Storm13Cloud/NanoFreak/NanoFreak.kicad_pcb

## KiCad design NanoFreak.kicad_pcb (2026-01-06)

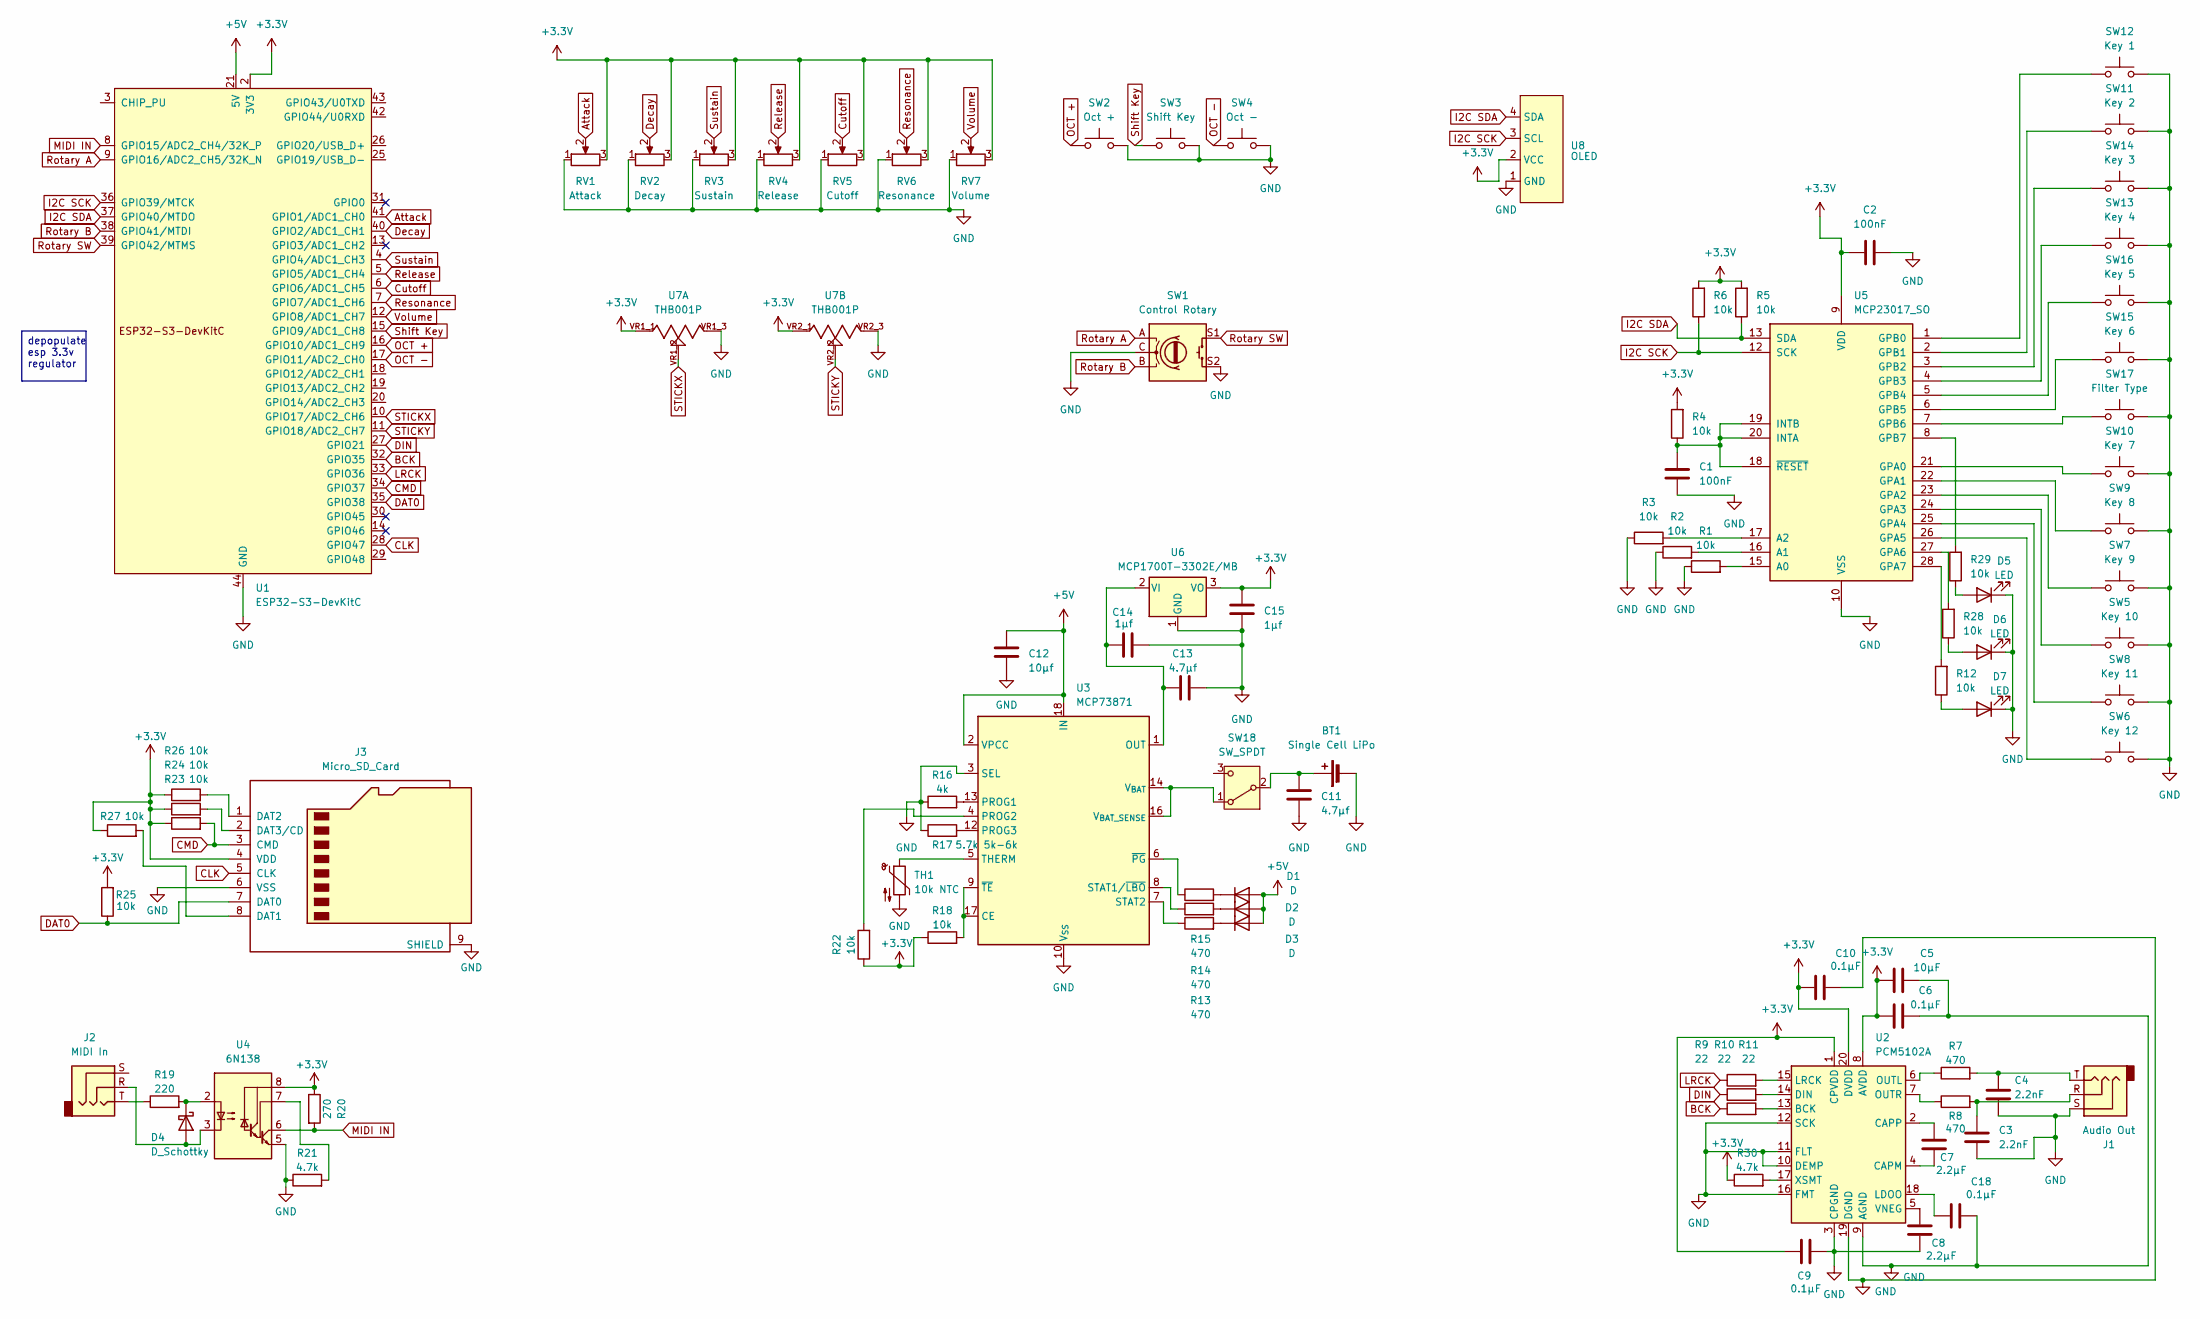
[picture p1: schematic NanoFreak.kicad_sch]

Parts:
BT1: Single Cell LiPo; BatteryHolder_Keystone_1042_1x18650
C1, C2: 100nF; C_0603_1608Metric_Pad1.08x0.95mm_HandSolder
C3, C4: 2.2nF; C_0603_1608Metric_Pad1.08x0.95mm_HandSolder
C5: 10µF; C_0603_1608Metric_Pad1.08x0.95mm_HandSolder
C6, C9, C10, C18: 0.1µF; C_0603_1608Metric_Pad1.08x0.95mm_HandSolder
C7, C8: 2.2µF; C_0603_1608Metric_Pad1.08x0.95mm_HandSolder
C11, C13: 4.7µf; C_0603_1608Metric_Pad1.08x0.95mm_HandSolder
C12: 10µf; C_0603_1608Metric_Pad1.08x0.95mm_HandSolder
C14, C15: 1µf; C_0603_1608Metric_Pad1.08x0.95mm_HandSolder
D1, D2, D3: D; D_0603_1608Metric_Pad1.05x0.95mm_HandSolder
D4: D_Schottky; D_0603_1608Metric_Pad1.05x0.95mm_HandSolder
D5, D6, D7: LED; LED_D3.0mm
J1: Audio Out; Jack_3.5mm_CUI_SJ1-3523N_Horizontal
J2: MIDI In; Jack_3.5mm_CUI_SJ1-3523N_Horizontal
J3: Micro_SD_Card; microSD_HC_Hirose_DM3AT-SF-PEJM5
R1, R2, R3, R4, R5, R6, R12, R18, R22, R23, R24, R25, R26, R27, R28, R29: 10k; R_0603_1608Metric
R7, R8, R13, R14, R15: 470; R_0603_1608Metric
R9, R10, R11: 22; R_0603_1608Metric
R16: 4k; R_0603_1608Metric
R17: 5.7k 5k-6k; R_0603_1608Metric
R19: 220; R_0603_1608Metric
R20: 270; R_0603_1608Metric
R21, R30: 4.7k; R_0603_1608Metric
RV1: Attack; Potentiometer
RV2: Decay; Potentiometer
RV3: Sustain; Potentiometer
RV4: Release; Potentiometer
RV5: Cutoff; Potentiometer
RV6: Resonance; Potentiometer
RV7: Volume; Potentiometer
SW1: Control Rotary; RotaryEncoder_Alps_EC11E-Switch_Vertical_H20mm
SW2: Oct +; SW_Push_1P1T_NO_CK_KMR2
SW3: Shift Key; SW_Push_1P1T_NO_CK_KMR2
SW4: Oct -; SW_Push_1P1T_NO_CK_KMR2
SW5: Key 10; SW_Cherry_MX_1.00u_PCB
SW6: Key 12; SW_Cherry_MX_1.00u_PCB
SW7: Key 9; SW_Cherry_MX_1.00u_PCB
SW8: Key 11; SW_Cherry_MX_1.00u_PCB
SW9: Key 8; SW_Cherry_MX_1.00u_PCB
SW10: Key 7; SW_Cherry_MX_1.00u_PCB
SW11: Key 2; SW_Cherry_MX_1.00u_PCB
SW12: Key 1; SW_Cherry_MX_1.00u_PCB
SW13: Key 4; SW_Cherry_MX_1.00u_PCB
SW14: Key 3; SW_Cherry_MX_1.00u_PCB
SW15: Key 6; SW_Cherry_MX_1.00u_PCB
SW16: Key 5; SW_Cherry_MX_1.00u_PCB
SW17: Filter Type; SW_Push_1P1T_NO_CK_KMR2
SW18: SW_SPDT; SW_SPDT_PCM12
TH1: 10k NTC; R_0603_1608Metric_Pad0.98x0.95mm_HandSolder
U1: ESP32-S3-DevKitC
U2: PCM5102A; TSSOP-20_4.4x6.5mm_P0.65mm
U3: MCP73871; QFN-20-1EP_4x4mm_P0.5mm_EP2.5x2.5mm
U4: 6N138; DIP-8_W7.62mm
U5: MCP23017_SO; SOIC-28W_7.5x17.9mm_P1.27mm
U6: MCP1700T-3302E/MB; SOT-89-3
U7: THB001P; CNK_THB001P; PARTREV 27 Jan 22
U8: OLED; OLED 128x64

Connections:
+3.3V: C2.1, C5.1, C6.1, C9.2, C10.1, C15.1, J3.4 (VDD), R4.2, R5.2, R6.2, R18.1, R20.1, R22.1, R23.1, R24.1, R25.2, R26.1, R27.1, R30.1, RV1.3, RV2.3, RV3.3, RV4.3, RV5.3, RV6.3, RV7.3, U1.1 (3V3), U1.2 (3V3), U2.1 (CPVDD), U2.8 (AVDD), U2.20 (DVDD), U4.8 (VCC), U5.9 (VDD), U6.3 (VO), U7.VR1_1, U7.VR2_1, U8.2 (VCC)
+5V: C12.1, D1.2 (A), D2.2 (A), D3.2 (A), U1.21 (5V), U3.2 (VPCC), U3.18 (IN), U3.19 (IN)
Attack: RV1.2, U1.41 (GPIO1/ADC1_CH0)
BCK: R11.1, U1.32 (GPIO35)
CLK: J3.5 (CLK), U1.28 (GPIO47)
CMD: J3.3 (CMD), R23.2, U1.34 (GPIO37)
Cutoff: RV5.2, U1.6 (GPIO6/ADC1_CH5)
DAT0: J3.7 (DAT0), R25.1, U1.35 (GPIO38)
DIN: R10.1, U1.27 (GPIO21)
Decay: RV2.2, U1.40 (GPIO2/ADC1_CH1)
GND: BT1.2 (-), C1.2, C2.2, C3.2, C4.2, C5.2, C6.2, C8.2, C9.1, C10.2, C11.2, C12.2, C13.2, C14.2, C15.2, C18.2, D5.1 (K), D6.1 (K), D7.1 (K), J1.S, J3.6 (VSS), J3.9 (SHIELD), R1.1, R2.1, R3.1, R16.1, R17.1, R21.1, RV1.1, RV2.1, RV3.1, RV4.1, RV5.1, RV6.1, RV7.1, SW1.C, SW1.S2, SW2.2, SW3.2, SW4.2, SW5.2, SW6.2, SW7.2, SW8.2, SW9.2, SW10.2, SW11.2, SW12.2, SW13.2, SW14.2, SW15.2, SW16.2, SW17.2, TH1.2, U1.22 (GND), U1.23 (GND), U1.24 (GND), U1.44 (GND), U2.3 (CPGND), U2.9 (AGND), U2.10 (DEMP), U2.11 (FLT), U2.12 (SCK), U2.16 (FMT), U2.19 (DGND), U3.3 (SEL), U3.10 (V_{SS}), U3.11 (V_{SS}), U3.21 (V_{SS}), U4.5 (GND), U5.10 (VSS), U6.1 (GND), U7.VR1_3, U7.VR2_3, U8.1 (GND)
I2C SCK: R6.1, U1.36 (GPIO39/MTCK), U5.12 (SCK), U8.3 (SCL)
I2C SDA: R5.1, U1.37 (GPIO40/MTDO), U5.13 (SDA), U8.4 (SDA)
LRCK: R9.1, U1.33 (GPIO36)
MIDI IN: R20.2, U1.8 (GPIO15/ADC2_CH4/32K_P), U4.6 (VO2)
unnamed: BT1.1 (+), C11.1, SW18.2 (B)
unnamed: C3.1, J1.R, R8.2
unnamed: C4.1, J1.T, R7.2
unnamed: D1.1 (K), R15.2
unnamed: D2.1 (K), R14.2
unnamed: D3.1 (K), R13.2
unnamed: D4.2 (A), J2.R, U4.3 (C2)
unnamed: D4.1 (K), R19.2, U4.2 (C1)
unnamed: D5.2 (A), R29.1
unnamed: D6.2 (A), R28.1
unnamed: D7.2 (A), R12.1
unnamed: J2.T, R19.1
unnamed: J3.8 (DAT1), R27.2
unnamed: J3.1 (DAT2), R26.2
unnamed: J3.2 (DAT3/CD), R24.2
unnamed: SW18.1 (A), U3.14 (V_{BAT}), U3.15 (V_{BAT}), U3.16 (V_{BAT_SENSE})
unnamed: R11.2, U2.13 (BCK)
unnamed: C7.2, U2.4 (CAPM)
unnamed: C7.1, U2.2 (CAPP)
unnamed: R10.2, U2.14 (DIN)
unnamed: C18.1, U2.18 (LDOO)
unnamed: R9.2, U2.15 (LRCK)
unnamed: R7.1, U2.6 (OUTL)
unnamed: R8.1, U2.7 (OUTR)
unnamed: C8.1, U2.5 (VNEG)
unnamed: R30.2, U2.17 (XSMT)
unnamed: R18.2, U3.9 (~TE), U3.17 (CE)
unnamed: R16.2, U3.13 (PROG1)
unnamed: R22.2, U3.4 (PROG2)
unnamed: R17.2, U3.12 (PROG3)
unnamed: R14.1, U3.8 (STAT1/~LBO)
unnamed: R13.1, U3.7 (STAT2)
unnamed: TH1.1, U3.5 (THERM)
unnamed: R15.1, U3.6 (~PG)
unnamed: R21.2, U4.7 (VO1)
unnamed: R1.2, U5.15 (A0)
unnamed: R2.2, U5.16 (A1)
unnamed: R3.2, U5.17 (A2)
unnamed: SW10.1, U5.21 (GPA0)
unnamed: SW9.1, U5.22 (GPA1)
unnamed: SW7.1, U5.23 (GPA2)
unnamed: SW5.1, U5.24 (GPA3)
unnamed: SW8.1, U5.25 (GPA4)
unnamed: SW6.1, U5.26 (GPA5)
unnamed: R28.2, U5.27 (GPA6)
unnamed: R12.2, U5.28 (GPA7)
unnamed: SW12.1, U5.1 (GPB0)
unnamed: SW11.1, U5.2 (GPB1)
unnamed: SW14.1, U5.3 (GPB2)
unnamed: SW13.1, U5.4 (GPB3)
unnamed: SW16.1, U5.5 (GPB4)
unnamed: SW15.1, U5.6 (GPB5)
unnamed: SW17.1, U5.7 (GPB6)
unnamed: R29.2, U5.8 (GPB7)
unnamed: C1.1, R4.1, U5.18 (~RESET), U5.19 (INTB), U5.20 (INTA)
unnamed: C13.1, C14.1, U3.1 (OUT), U3.20 (OUT), U6.2 (VI)
OCT +: SW2.1, U1.16 (GPIO10/ADC1_CH9)
OCT -: SW4.1, U1.17 (GPIO11/ADC2_CH0)
Release: RV4.2, U1.5 (GPIO5/ADC1_CH4)
Resonance: RV6.2, U1.7 (GPIO7/ADC1_CH6)
Rotary A: SW1.A, U1.9 (GPIO16/ADC2_CH5/32K_N)
Rotary B: SW1.B, U1.38 (GPIO41/MTDI)
Rotary SW: SW1.S1, U1.39 (GPIO42/MTMS)
STICKX: U1.10 (GPIO17/ADC2_CH6), U7.VR1_2
STICKY: U1.11 (GPIO18/ADC2_CH7), U7.VR2_2
Shift Key: SW3.1, U1.15 (GPIO9/ADC1_CH8)
Sustain: RV3.2, U1.4 (GPIO4/ADC1_CH3)
Volume: RV7.2, U1.12 (GPIO8/ADC1_CH7)

Notes on the sheet:
depopulate esp 3.3v regulator

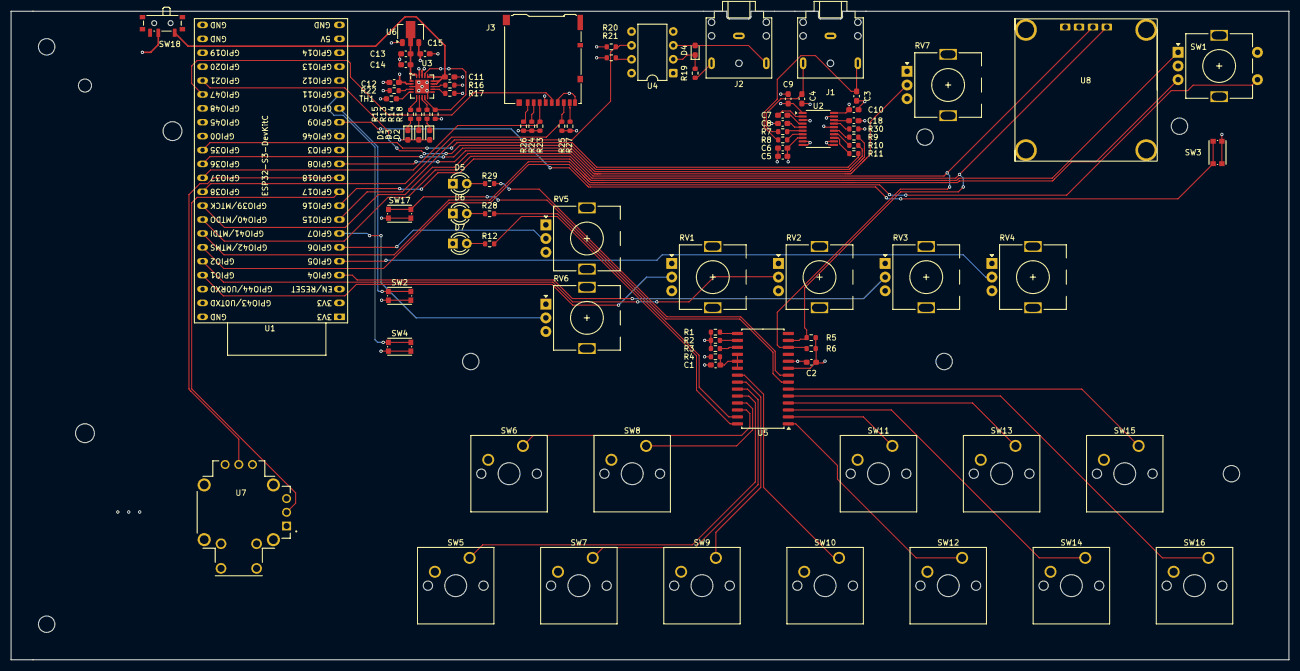
[picture p2: board NanoFreak.kicad_pcb from above]

Board: 4 copper layers, 233.5 x 118.5 mm, 91 parts (1 on the bottom side), 83 nets.
