Storm13Cloud/NanoFreak/KeyPins.h

#ifndef PIN_DEFINITIONS_H
#define PIN_DEFINITIONS_H

#include <Arduino.h>

const uint8_t KEY1 = 3;
const uint8_t KEY2 = 5;
const uint8_t KEY3 = 2;
const uint8_t KEY4 = 4;
const uint8_t KEY5 = 1;
const uint8_t KEY6 = 0;
const uint8_t KEY7 = 9;
const uint8_t KEY8 = 8;
const uint8_t KEY9 = 11;
const uint8_t KEY10 = 10;
const uint8_t KEY11 = 13;
const uint8_t KEY12 = 12;
const uint8_t LPLED = 15;
const uint8_t BPLED = 6;
const uint8_t HPLED = 7;
const uint8_t FILTERTYPE = 14;

#endif // PIN_DEFINITIONS_H
